ntpt7921/CompEngProj/Report/Text/FirstStage/MainBody/content/00_a_declaration.tex

\hypertarget{declaration}{%
\chapter*{Declaration}\label{declaration}}
\addcontentsline{toc}{chapter}{Declaration}

I hereby declare that this thesis has been written by my own, and that the contents presented herein
are solely my own work, unless explicitly acknowledged otherwise within the text. Furthermore, I
affirm that this work has not been previously submitted for the purpose of obtaining any other
academic degree or professional qualification.

Additionally, I affirm that this project - all ideas, design, implementation and writting - is done
without any usage of generative AI.

\vspace{2cm}

\begin{tabular}{@{}p{4in}@{}}
\hrulefill \\
Nguyễn Trần Phước Thành \\
12/2023 \\
\end{tabular}
