ntpt7921/CompEngProj/Report/Text/FirstStage/MainBody/content/00_b_acknowledgement.tex

\hypertarget{acknowledgement}{%
\chapter*{Acknowledgement}\label{acknowledgement}}
\addcontentsline{toc}{chapter}{Acknowledgement}

I would like to extend my gratitude to Phạm Quốc Cường, my instructor for this project.

And a massive thank to my mother and father, whose support and encouragement throughout the years
has helped me for more times than I can count. I own them more than I can ever express.
