ntpt7921/CompEngProj/Report/Slide/Final/image/hubris-vivado-block-design.png

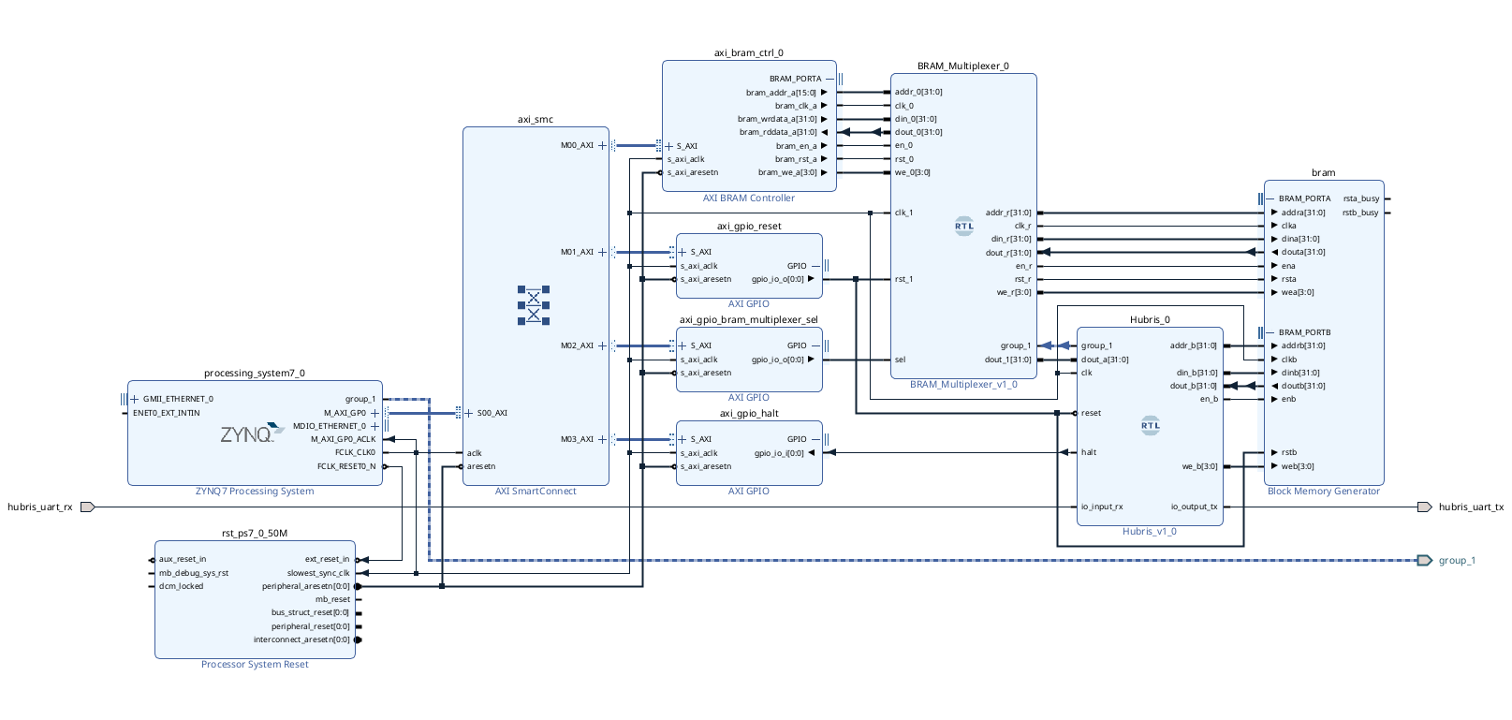
Report/Slide/Final/image/hubris-vivado-block-design.png
