ntpt7921/CompEngProj/Report/Slide/Final/image/power-summary.png

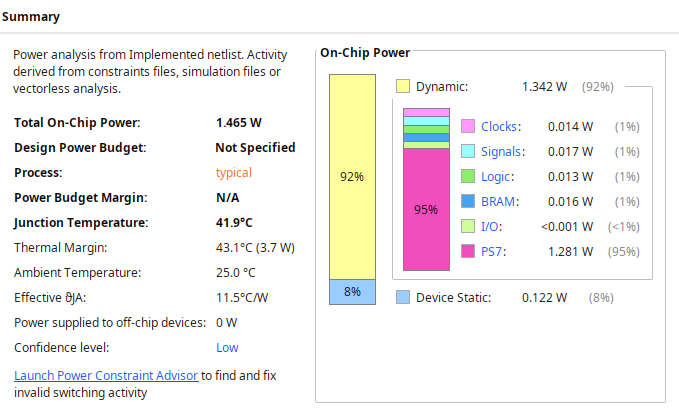
Report/Slide/Final/image/power-summary.png
