ntpt7921/CompEngProj/Report/Slide/Final/image/snake-game-visual.png

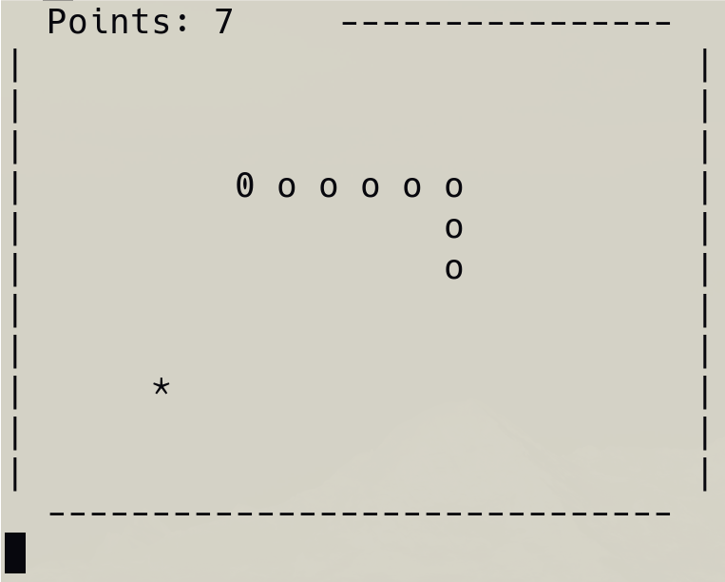
Report/Slide/Final/image/snake-game-visual.png
