ntpt7921/CompEngProj/Report/Slide/Final/image/timing-summary.png

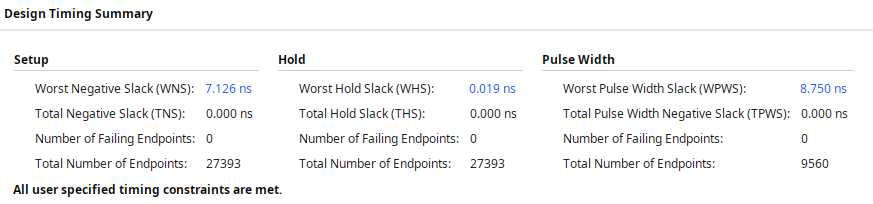
Report/Slide/Final/image/timing-summary.png
