ntpt7921/CompEngProj/Report/Slide/Final/image/utilization-breakdown.png

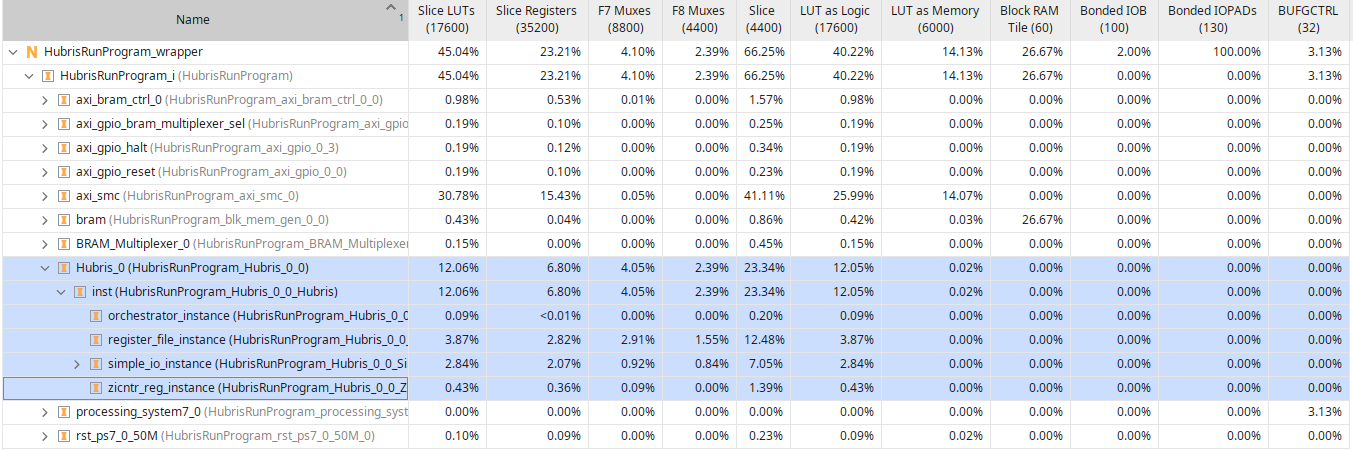
Report/Slide/Final/image/utilization-breakdown.png
