ntpt7921/CompEngProj/Report/Slide/Final/image/utilization-summary.png

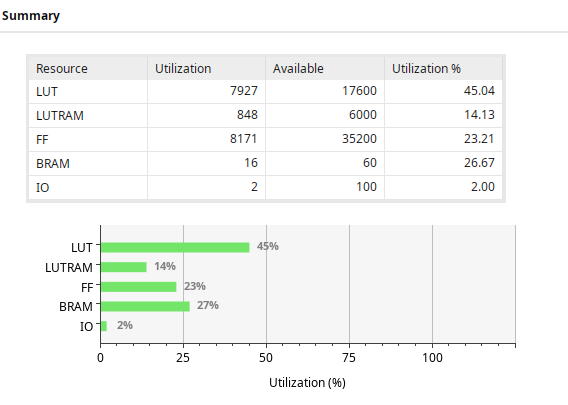
Report/Slide/Final/image/utilization-summary.png
