ntpt7921/CompEngProj/Report/Text/FirstStage/MainBody/img/processor_5stage_pipeline.drawio.png

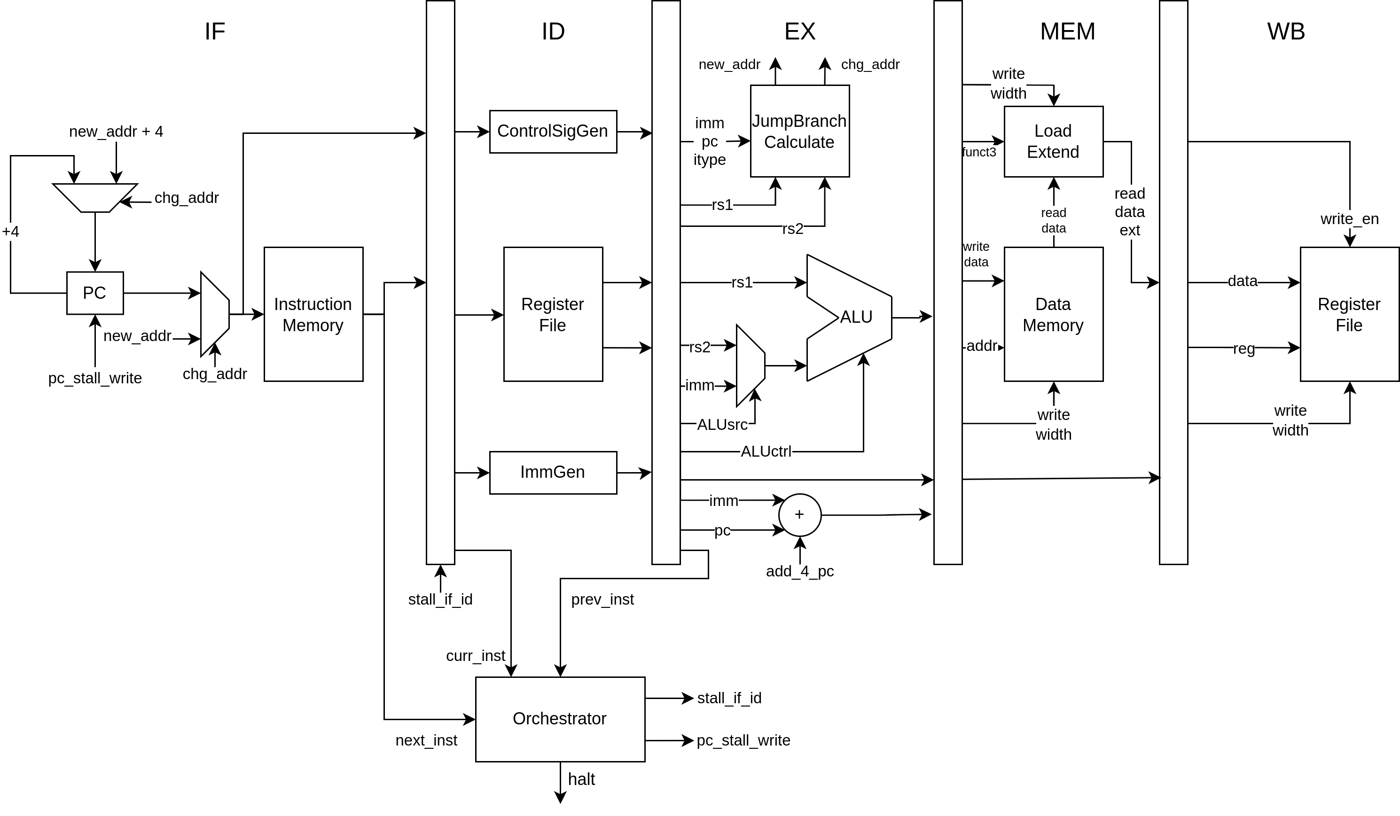
Report/Text/FirstStage/MainBody/img/processor_5stage_pipeline.drawio.png
