ntpt7921/CompEngProj/Report/Slide/Final/image/assembly-test-prog-result.png

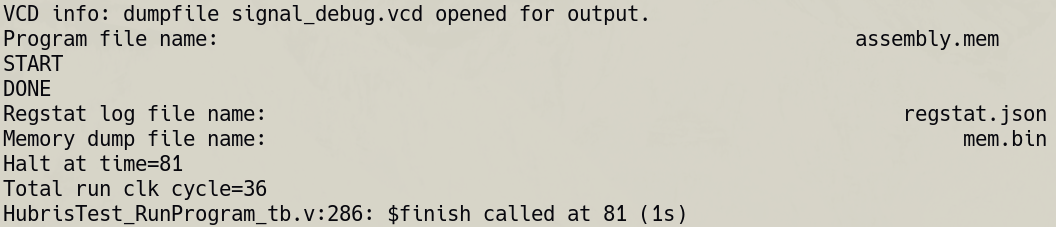
Report/Slide/Final/image/assembly-test-prog-result.png
