ntpt7921/CompEngProj/Report/Slide/Final/image/c-test-prog-result.png

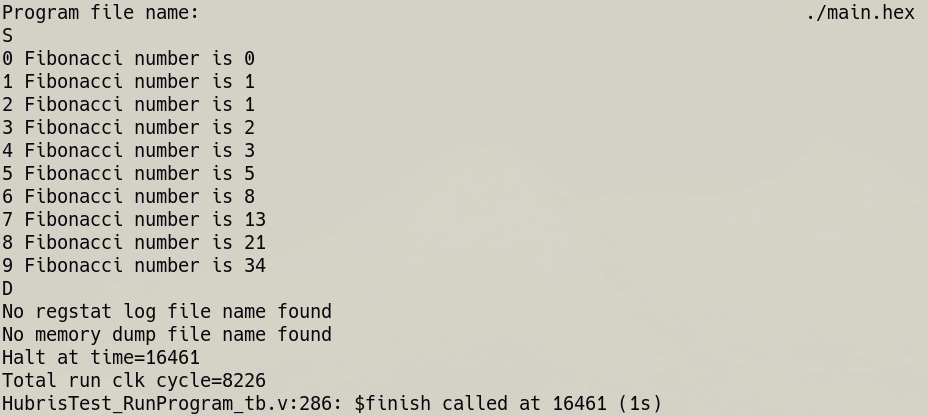
Report/Slide/Final/image/c-test-prog-result.png
