ntpt7921/CompEngProj/Report/Slide/Final/image/fib-sort-uart_result.png

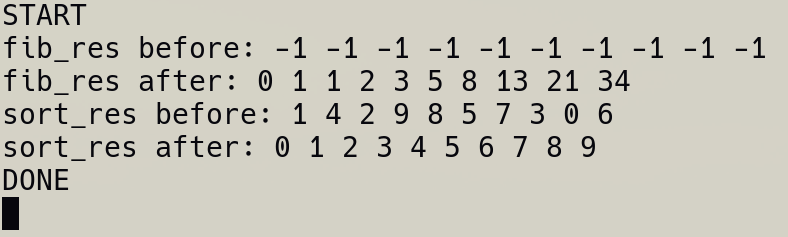
Report/Slide/Final/image/fib-sort-uart_result.png
