ntpt7921/CompEngProj/Report/Text/Final/img/dhrystone-uart-result.png

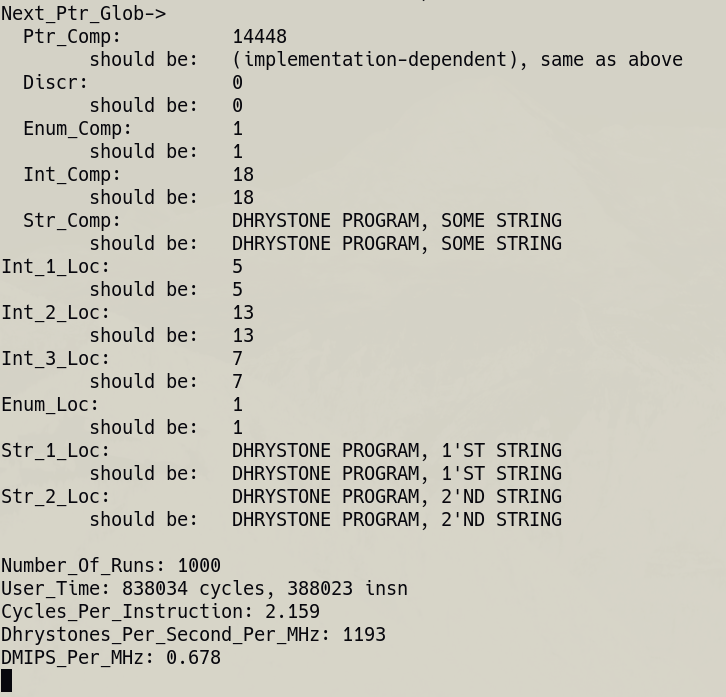
Report/Text/Final/img/dhrystone-uart-result.png
