ntpt7921/CompEngProj/(commit log)

2023-12-14 Add current work on Hubris
    Done:
    - Memory (data/instruction)
    - Register file
    - Immediate generator (have not test with testbench)
2023-12-18 Done the text report for first stage
2024-03-15 Add slide for first stage, rename slide directory
2024-03-17 Combine all into Hubris
    Also add the LoadExtend module into the MEM stage to sign extend value
    read from memory.
    Untested, for now, preliminary testing start with next commit.
2024-03-25 Fix memory system to unified memory
    Implement a simple fix to address instruction and data memory under the
    same memory address space (by encapsulate InstMemory and DataMemory
    under UnifiedMemory).
    [CtrlSignalGen.v, Hubris.v, LoadExtend.v, Orchestrator.v, RegisterFile.v]
2024-05-05 Add RISCOF test bed
    Contains all the necessary config file for testing Hubris design against
    RV32I architecture test.
2024-05-06 Some rudimentary debug for Hubris
    Fixes:
    - Update stall logic for dependent instruction that changes rd
    - Update RegisterFile to implement x0
    - Fixes mistakes in using function without defining output width
    [CtrlSignalGen.v, Hubris.v, ImmediateGen.v, Orchestrator.v, RegisterFile.v]
2024-05-10 Add support for memory-mapped IO output
    Changes are made to NewUnifiedMemory module, making use of
    DirectionalBuffer to implement IO output which is memory-mapped to
    0x8000_0000 and above.
    The HubrisTest_RunProgram_tb is also changed to detect available output
    and print them out.
2024-05-15 Move LoadExtend out of MEM stage and into WB stage
2024-05-23 Add final report
    Some other changes were made to implementation when porting to hardware.
    This include some bug fix.
    [DirectionalBuffer.v, Hubris.v]
2024-05-30 Adding UART output for Hubris
    Hubris will have the ability to output UART in 921600 bps (assuming
    using 50MHz internal clock).
    The testbench is changed to collect and print out this new type of
    output, and as a result has become slower (but still acceptable).
2024-06-02 Fix and test UART input for Hubris
    Now the testbench can write characters into UART. The test program can
    wait for character and print back what is received (loop back).
    For now in simulation/implementation, Hubris can read/write with UART
    (921600 bps).
    [Hubris.v, HubrisTest_RunProgram_tb.v, SimpleIO.v]
2024-06-04 Add snake program
    Bug in SimpleIO enable logic within Hubris is fixed also.
    [CtrlSignalGen.v, Hubris.v, HubrisTest_RunProgram_tb.v, main.c, stdlib.c]
